pluggee/R1102/Readme.md

# R1102

particle.io electron Interposer
